GeekTheGreyBeard/RabbiRack/images/phone-v1.1/README.md

# Phone v1.1 fitted assembly

`IMG_0106-redacted.png` is the owner-supplied photograph, with authorized opaque masking of lock-screen contact text. It preserves all decoded pixels outside the mask, original 1536 × 1152 dimensions and orientation, and contains no EXIF/GPS or embedded metadata. The private original and rejected generative edit are not published.
