GeekTheGreyBeard/RabbiRack/docs/phone-retention.md

# Phone v1.0 — historical inadequate-retention reference

**Do not print this revision for use. The owner reports that its retainers are too open to hold the phone securely.**

The owner confirmed on October 24, 2026 that the overall size works with RabbiRack, before the later v1.1 correction. That confirms neither secure device retention nor a finished phone-holder design. This historical revision remains unchanged; use the linked v1.1 correction for the owner-tested setup.

The historical reference files are in `models/phone-v1.0-reference/`; `source/buildPhoneReference.py` reproduces them. The completed local plate contained one 106 × 212 mm panel, four original lower caps and four V2 joint keys. The lower-cap reference remains `models/lower-cap-0p20.stl` rather than a duplicate copy. Successful machine completion did not establish retention.

Design reference: Galaxy S25 Ultra in UAG Plasma XTE MagSafe Ash/Titanium, SKU 214467113136. The earlier nominal case envelope was 169.418 × 87.376 × 15.24 mm from the manufacturer's 6.67 × 3.44 × 0.6 inch dimensions: https://www.urbanarmorgear.com/products/plasma-xte-galaxy-s25-ultra-case/ . This envelope is not detailed camera, button or kickstand CAD.

The former digital envelope checks did not detect the real retention problem. The owner subsequently measured the gaps; [phone v1.1](phone-v1.1.md) applies those peg-only corrections and has owner-verified physical retention without caps. This older geometry remains unchanged for provenance.
