GeekTheGreyBeard/RabbiRack/docs/attribution.md

# Reuse, attribution and third-party notices

## Owner's original contributions: CC0-1.0

On October 25, 2026, Rodney (GeekTheGreyBeard) requested a public version 1 release free for everyone to use as they wish. To the extent he owns the rights, his original RabbiRack geometry, source, documentation and supplied photographs are dedicated under CC0-1.0. No attribution obligation is added. The complete unmodified legal text is in [LICENSE](../LICENSE), obtained from the [SPDX canonical CC0-1.0 text](https://github.com/spdx/license-list-data/blob/main/text/CC0-1.0.txt), checked against [Creative Commons legal code](https://creativecommons.org/publicdomain/zero/1.0/legalcode.en).

The project was developed with AI assistance. This records provenance, without claiming copyright in material where no such rights exist. No conflicting inbound source-code license was found in the reviewed tracked project. Blender and its Python API are external build dependencies; Blender itself is not redistributed or relicensed here.

## Exclusions and retained notices

- Rabbit and r1 identify the compatible device. No affiliation, sponsorship or endorsement is claimed. CC0 grants no trademark or patent rights.
- The base's recessed Rabbit emblem and `source/references/official_logo_trace.json` derive from the official Rabbit favicon at https://www.rabbit.tech/favicon.png . They are vendor artwork, **excluded from the owner's CC0 dedication**. Their presence does not grant permission to use the mark or transfer ownership of it. The base STL contains that emblem, so its original mechanical contribution and vendor-artwork exclusion both apply. Reusers must assess rights to vendor artwork independently.
- Device and vendor marks visible in photographs remain the respective owners' marks. The owner's photographic contribution is CC0; it does not transfer rights in depicted third-party artwork or products.
- Samsung Galaxy S25 Ultra and UAG Plasma XTE names identify compatibility of an unsuitable historical phone reference. No endorsement is claimed; that reference is not a stable printing recommendation.

CC0's standard limitations and warranty disclaimer apply. These notices define rights scope and preserve provenance; they do not impose a new attribution requirement on original CC0 material.
