GeekTheGreyBeard/RabbiRack/images/acceptedParts.png

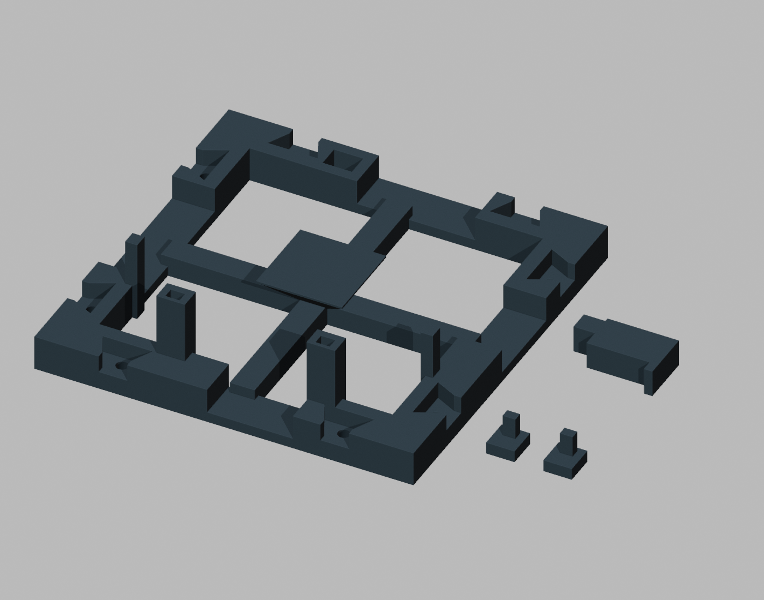
images/acceptedParts.png
