GeekTheGreyBeard/RabbiRack/models/base-v1.0/rear-foot.stl

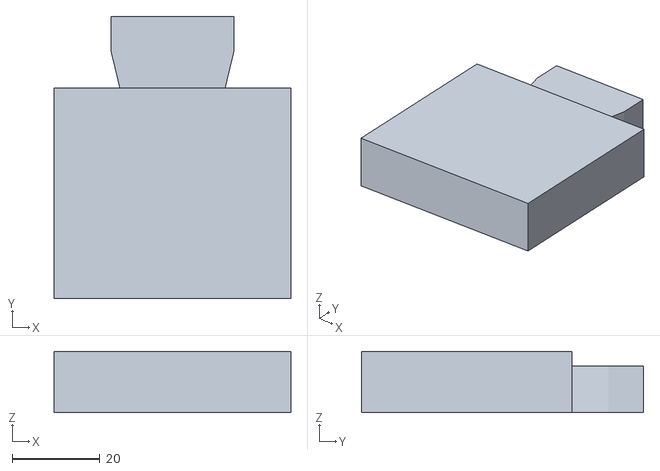
[picture p7: CAD file, 2026-10-24]
models/base-v1.0/rear-foot.stl
54.0 x 64.3 x 14.0
