GeekTheGreyBeard/RabbiRack/models/lower-cap-0p20.stl

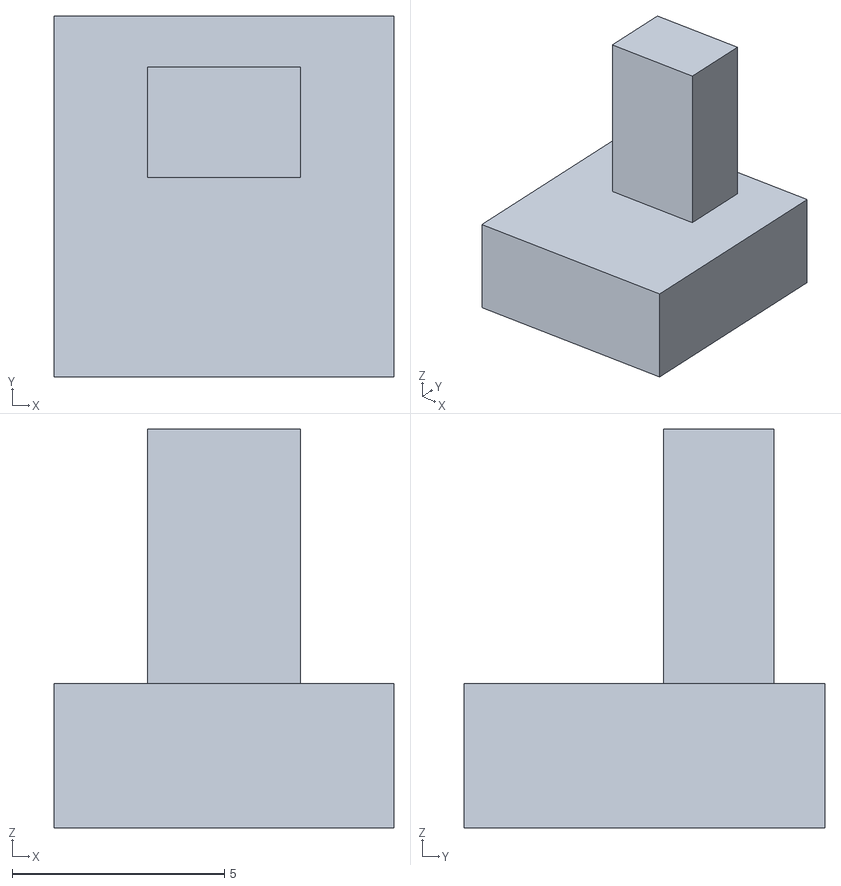
[picture p8: CAD file, 2026-10-19]
models/lower-cap-0p20.stl
8.00 x 8.50 x 9.40
