GeekTheGreyBeard/RabbiRack/models/phone-v1.0-reference/phone-panel.stl

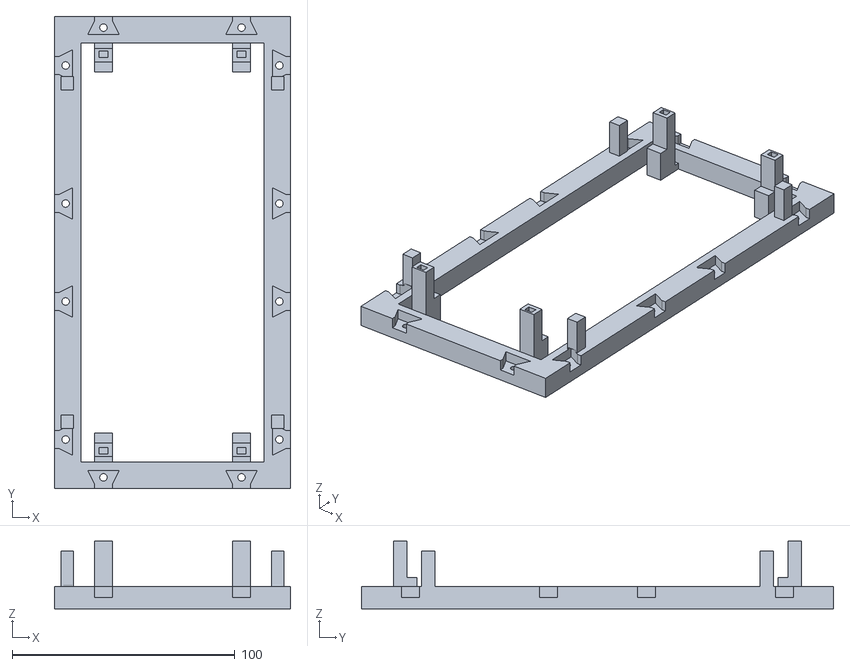
[picture p9: CAD file, 2026-10-24]
models/phone-v1.0-reference/phone-panel.stl
106.0 x 212.0 x 30.4
