GeekTheGreyBeard/RabbiRack/models/phone-v1.1/phone-panel.stl

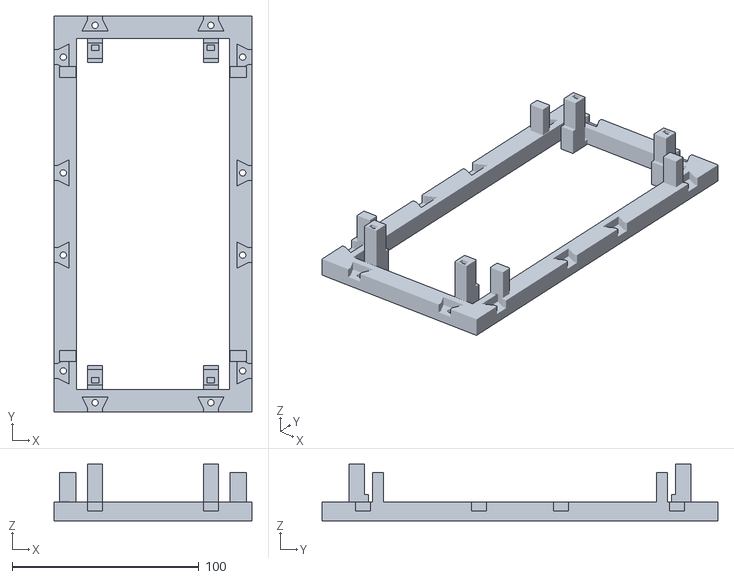
[picture p10: CAD file, 2026-10-27]
models/phone-v1.1/phone-panel.stl
106.0 x 212.0 x 30.4
