GeekTheGreyBeard/RabbiRack/models/trim-closed-v1.1/rack-top.stl

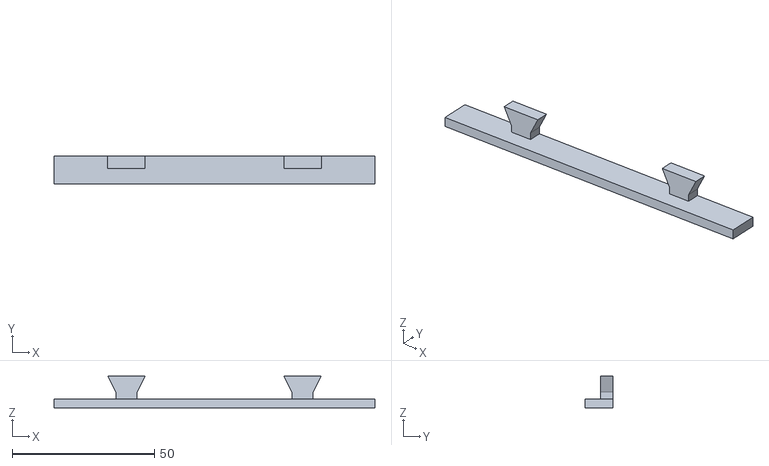
[picture p11: CAD file, 2026-10-26]
models/trim-closed-v1.1/rack-top.stl
113.0 x 10.0 x 11.3
