GeekTheGreyBeard/RabbiRack/models/trim-v1.0/stack-key.stl

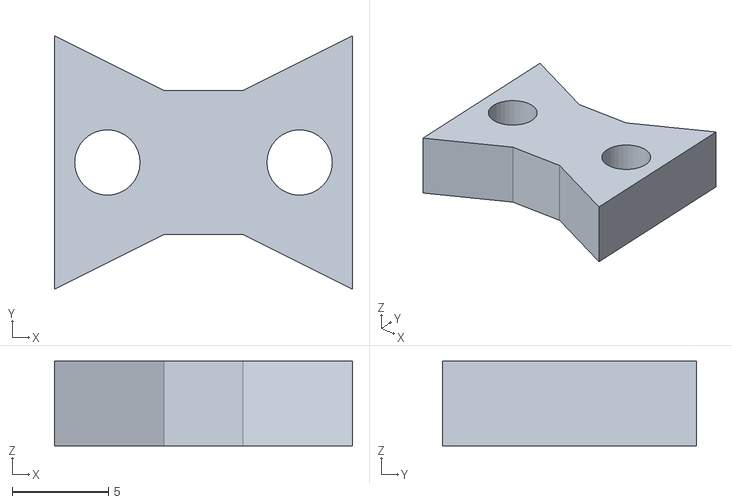
[picture p12: CAD file, 2026-10-24]
models/trim-v1.0/stack-key.stl
15.5 x 13.2 x 4.40
