GeekTheGreyBeard/RabbiRack/models/base-v1.0/base-fitment.stl

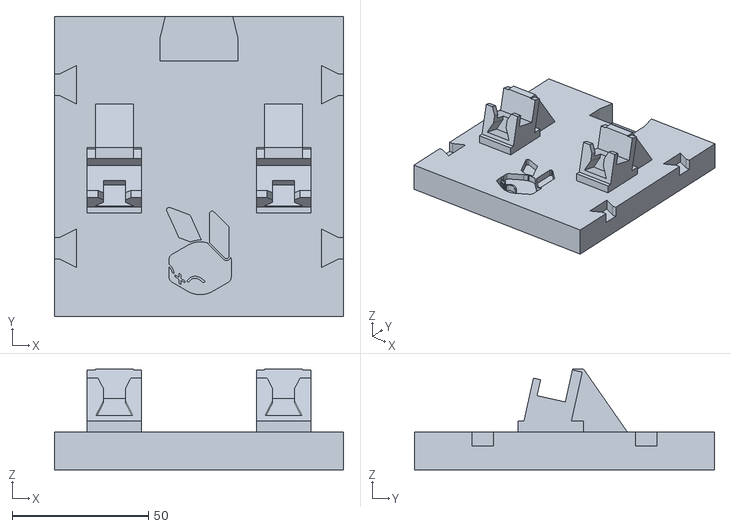
[picture p13: CAD file, 2026-10-24]
models/base-v1.0/base-fitment.stl
106.0 x 110.0 x 37.0
