GeekTheGreyBeard/RabbiRack/models/corrected-rack-section.stl

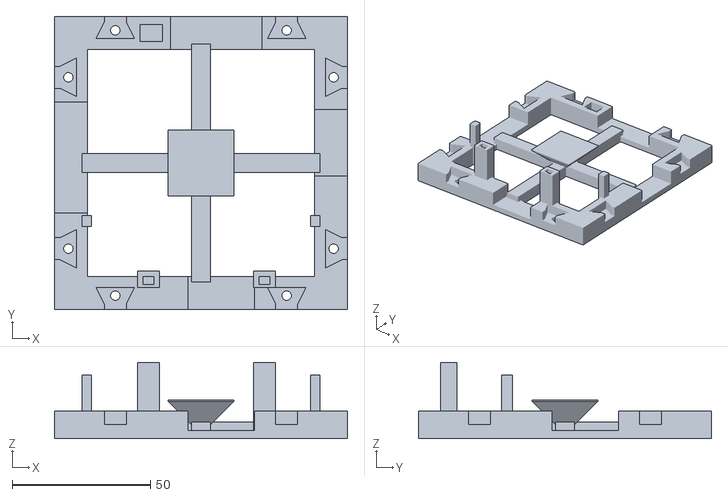
[picture p14: CAD file, 2026-10-19]
models/corrected-rack-section.stl
106.0 x 106.0 x 27.6
