GeekTheGreyBeard/RabbiRack/models/trim-closed-v1.1/rack-left.stl

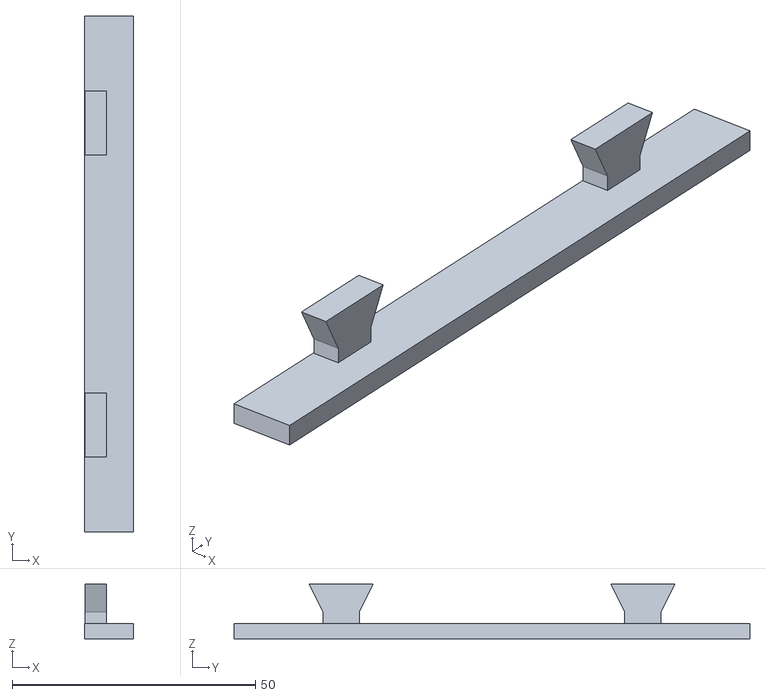
[picture p15: CAD file, 2026-10-26]
models/trim-closed-v1.1/rack-left.stl
10.0 x 106.0 x 11.3
