GeekTheGreyBeard/RabbiRack/models/keeper-0p25.stl

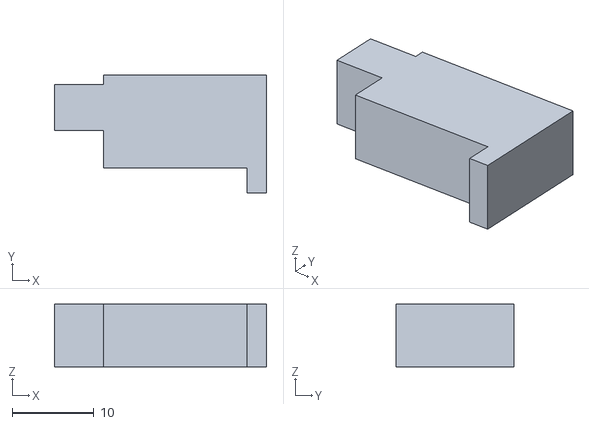
[picture p16: CAD file, 2026-10-19]
models/keeper-0p25.stl
26.0 x 14.5 x 7.70
