GeekTheGreyBeard/RabbiRack/models/trim-closed-v1.1/base-left.stl

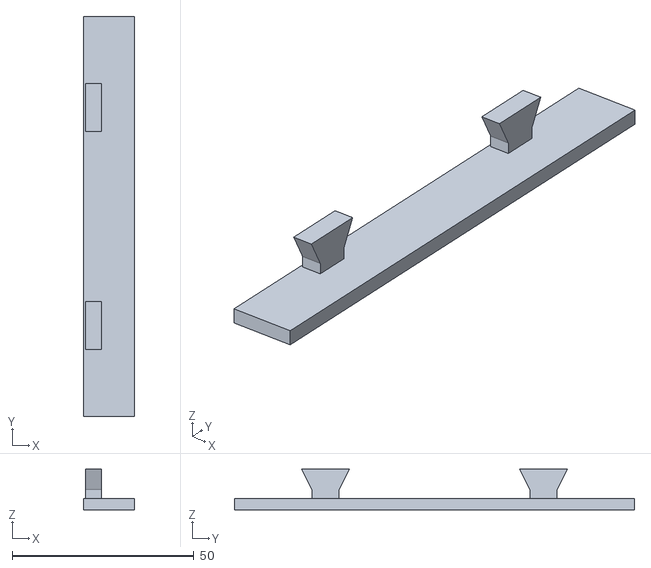
[picture p17: CAD file, 2026-10-24]
models/trim-closed-v1.1/base-left.stl
14.0 x 110.0 x 11.3
