GeekTheGreyBeard/RabbiRack/models/trim-v1.0/rack-left.stl

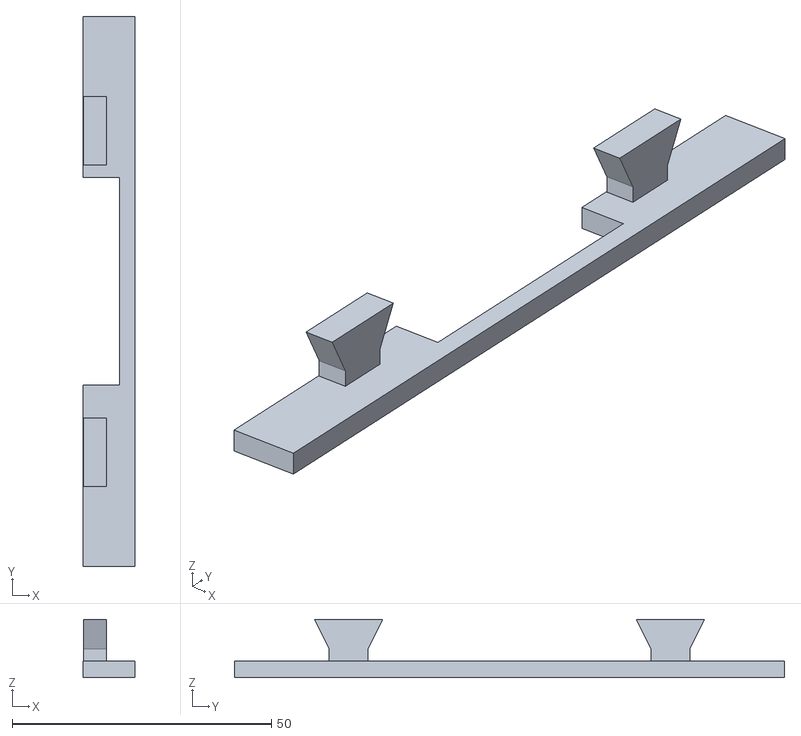
[picture p18: CAD file, 2026-10-24, an earlier design]
models/trim-v1.0/rack-left.stl
10.0 x 106.0 x 11.3
