GeekTheGreyBeard/RabbiRack/models/trim-v1.0/rack-top.stl

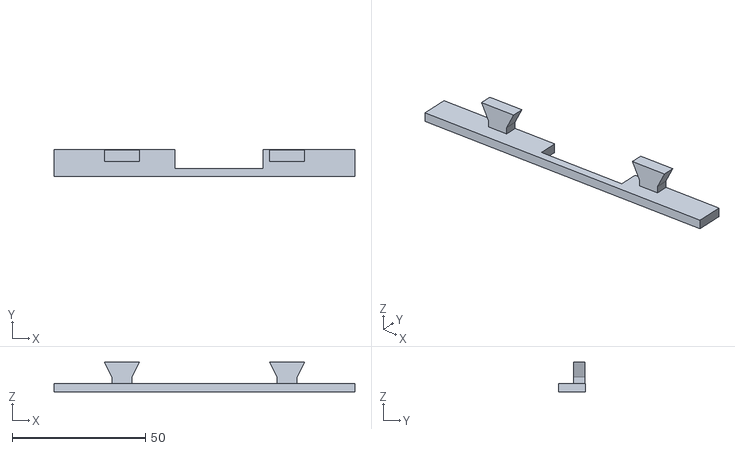
[picture p19: CAD file, 2026-10-24, an earlier design]
models/trim-v1.0/rack-top.stl
113.0 x 10.0 x 11.3
