GeekTheGreyBeard/RabbiRack/(list of files, cad)

Other CAD files:
models/phone-v1.0-reference/joint-key-0p25.stl
models/base-v1.0/attachment-key-0p25.stl
models/trim-closed-v1.1/rack-right.stl
models/trim-closed-v1.1/base-right.stl
models/trim-v1.0/rack-right.stl
