GeekTheGreyBeard/RabbiRack/images/baseAssembly.png

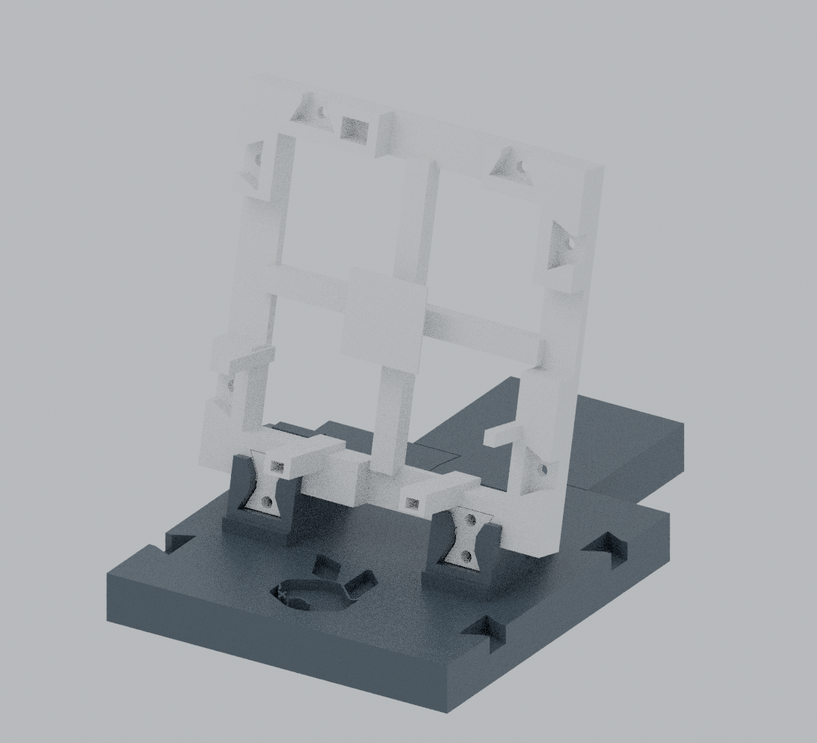
images/baseAssembly.png
