GeekTheGreyBeard/RabbiRack/CHANGELOG.md

# Phone v1.1 main-branch addition — 2026-10-27

- Publish exact successfully printed, owner-fit-verified phone panel and portable generator.
- Add 2.38125 mm inward end contact reach and 3.175 mm inward side reach per opposing contact; outer frame/interfaces unchanged.
- Document owner acceptance without removable caps; no caps printed/tested in this revision.
- Preserve historical v1.0 and frozen release; owner fitted-assembly photo published with authorized contact-text masking and metadata removal.

# Changelog

## Unreleased — closed trim documentation

- Added exact closed rail meshes from the active red print, portable source, fitting diagram, quantities and instructions. Physical fit pending.
- Documented isolated-column top caps and their overlap limitation for adjacent columns. No geometry or v1.0.0 release assets changed.

## v1.0.0 — 2026-10-25

- First tagged public RabbiRack release: accepted Rabbit cell, keeper/lower caps, fit-verified expanding base, removable rear foot and bowtie interfaces.
- Added three owner-supplied populated two-by-two assembly photographs, with private background monitor content redacted and metadata removed.
- Added layout BOM, assembly/cable-routing, print and source-build guidance; preserved original model geometry.
- Applied CC0-1.0 to the owner's original contributions, with vendor artwork/trademark and third-party exclusions retained.
- Separated stable model assets from reference-only notched trim and the known inadequate-retention phone panel. Closed trim remains in-progress local printing, not a tested stable asset.
- No machine-specific G-code, private source photographs or credentials included.
