GeekTheGreyBeard/RabbiRack/(commit log)

2026-10-19 Publish accepted RabbiRack meshes, reproducible source and synthetic render
    [corrected-rack-section.stl, keeper-0p25.stl, lower-cap-0p20.stl]
2026-10-24 Add fit-verified base and current trim and phone reference designs
    [attachment-key-0p25.stl, base-fitment.stl, base-left.stl, base-right.stl, joint-key-0p25.stl, phone-panel.stl, rack-left.stl, rack-right.stl]
2026-10-25 Release RabbiRack v1 with assembly photos, CC0 scope and build guides
2026-10-26 Add closed trim v1.1 models and illustrated fitting guide
    [base-left.stl, base-right.stl, rack-left.stl, rack-right.stl, rack-top.stl]
2026-10-27 Publish owner-fit-verified phone holder v1.1
    [phone-panel.stl]
2026-10-27 Add privacy-redacted owner phone-holder assembly photo
